Shmcandi/PCB-business-card-V2/fab_v2/BOM.csv

Comment/Value | Designator | Footprint | Quantity
100k | R7, R12 | R_0603_1608Metric | 2
100nF | C5, C9, C10 | C_0603_1608Metric | 3
10k | R4, R10 | R_0603_1608Metric | 2
10uF | C3, C4, C6, C8 | C_0805_2012Metric | 4
125k Wire Pads | J3 | PinHeader_1x02_P2.54mm_Vertical_SMD_Pin1Left | 1
125kHz Coil | L1 | L_1812_4532Metric | 1
1k | R6, R11 | R_0603_1608Metric | 2
1uF | C7 | C_0603_1608Metric | 1
3.3k | R3 | R_0603_1608Metric | 1
4.7k | R8, R9 | R_0603_1608Metric | 2
4.7uF | C1, C2 | C_0805_2012Metric | 2
470pF | C12 | C_0603_1608Metric | 1
5.1k | R1, R2 | R_0603_1608Metric | 2
AP2112K-3.3 | U3 | SOT-23-5 | 1
ATA5577C | U5 | SOIC-8_3.9x4.9mm_P1.27mm | 1
BATT JST-PH | J2 | JST_PH_S2B-PH-SM4-TB_1x02-1MP_P2.00mm_Horizontal | 1
BOOT | SW2 | SW_SPST_PTS810 | 1
BSS138 | Q2 | SOT-23 | 1
CHG | D1 | LED_0603_1608Metric | 1
DMG2305UX | Q1 | SOT-23 | 1
EN | SW1 | SW_SPST_PTS810 | 1
ESP32-C6-MINI-1-N4 | U1 | ESP32-C6-MINI-1 | 1
MCP73831T-2ACI/OT | U2 | SOT-23-5 | 1
NT3H2111W0FHK | U4 | TSSOP-8_3x3mm_P0.65mm | 1
NetTie-2 | NT1 | NetTie-2_SMD_Pad0.5mm | 1
USB-C (USB4105) | J1 | USB_C_Receptacle_GCT_USB4105-xx-A_16P_TopMnt_Horizontal | 1
USER | SW3 | SW_SPST_PTS810 | 1
WS2812B-2020 | LED59, LED55, LED26, LED87, LED67, LED21, LED79, LED37, LED25, LED44, LED96, LED93, LED6, LED15, LED63, LED66, LED94, LED13, LED18, LED60, LED12, LED46, LED78, LED86, LED28, LED75, LED89, LED19, LED29, LED43, LED56, LED20, LED34, LED52, LED64, LED69, LED82, LED83, LED33, LED80, LED38, LED42, LED9, LED48, LED40, LED51, LED8, LED50, LED74, LED32, LED22, LED88, LED2, LED17, LED1, LED4, LED11, LED58, LED3, LED7, LED65, LED77, LED85, LED39, LED71, LED76, LED53, LED61, LED45, LED14, LED23, LED16, LED47, LED24, LED5, LED10, LED49, LED84, LED90, LED95, LED41, LED62, LED68, LED91, LED27, LED73, LED35, LED72, LED54, LED31, LED92, LED57, LED70, LED81, LED36, LED30 | LED_WS2812B-2020 | 96
