Shmcandi/PCB-business-card-V2/card_v2.kicad_pcb

## KiCad design card_v2.kicad_pcb (2026-11-01)

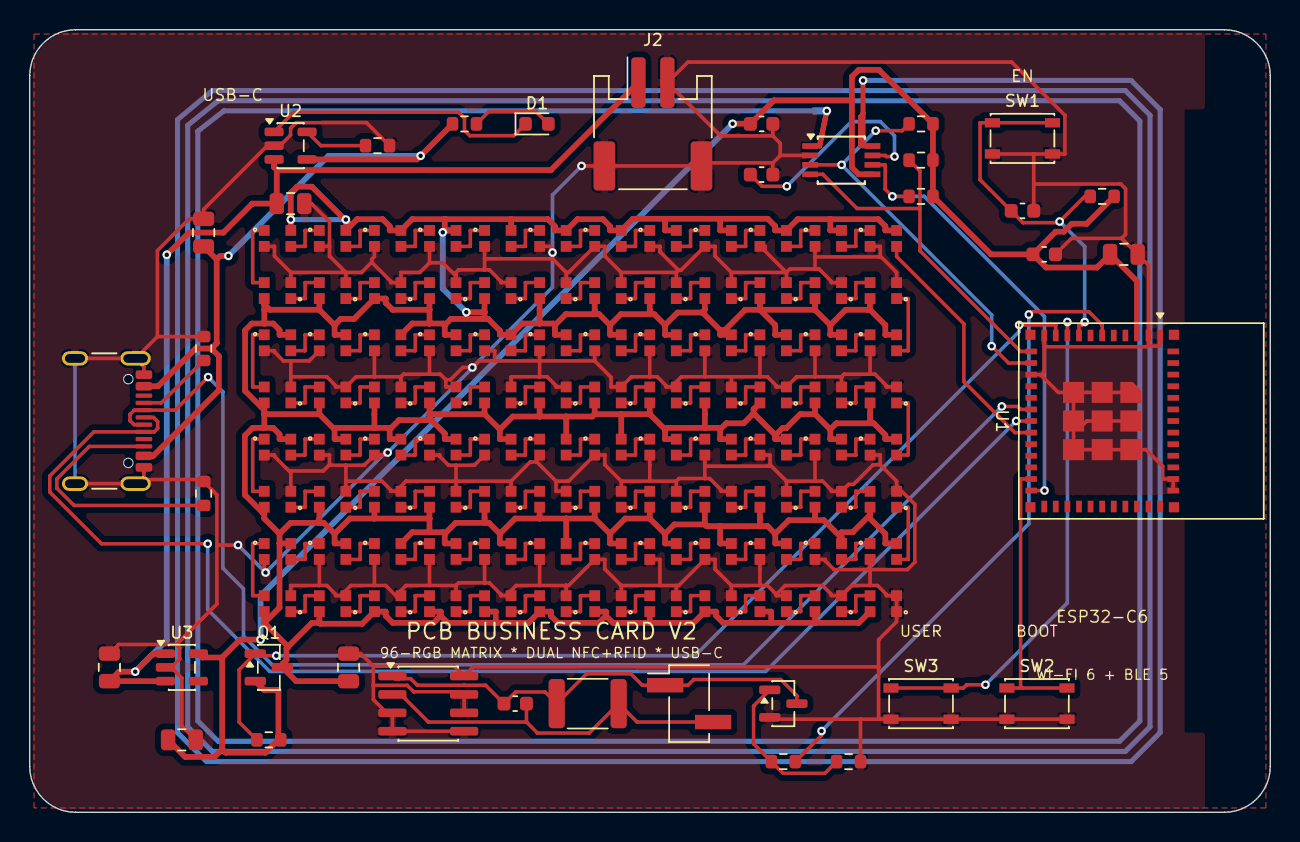
[picture p4: board card_v2.kicad_pcb from above]

Board: 2 copper layers, 85.6 x 54.0 mm, 134 parts (1 on the bottom side), 122 nets.

Parts:
C1, C2: 4.7uF; C_0805_2012Metric
C3, C4, C6, C8: 10uF; C_0805_2012Metric
C5, C9, C10: 100nF; C_0603_1608Metric
C7: 1uF; C_0603_1608Metric
C12: 470pF; C_0603_1608Metric
D1: CHG; LED_0603_1608Metric
J1: USB-C (USB4105); USB_C_Receptacle_GCT_USB4105-xx-A_16P_TopMnt_Horizontal
J2: BATT JST-PH; JST_PH_S2B-PH-SM4-TB_1x02-1MP_P2.00mm_Horizontal
J3: 125k Wire Pads; PinHeader_1x02_P2.54mm_Vertical_SMD_Pin1Left
L1: 125kHz Coil; L_1812_4532Metric
LED1, LED2, LED3, LED4, LED5, LED6, LED7, LED8, LED9, LED10, LED11, LED12, LED13, LED14, LED15, LED16, LED17, LED18, LED19, LED20, LED21, LED22, LED23, LED24, LED25, LED26, LED27, LED28, LED29, LED30, LED31, LED32, LED33, LED34, LED35, LED36, LED37, LED38, LED39, LED40, LED41, LED42, LED43, LED44, LED45, LED46, LED47, LED48, LED49, LED50, LED51, LED52, LED53, LED54, LED55, LED56, LED57, LED58, LED59, LED60, LED61, LED62, LED63, LED64, LED65, LED66, LED67, LED68, LED69, LED70, LED71, LED72, LED73, LED74, LED75, LED76, LED77, LED78, LED79, LED80, LED81, LED82, LED83, LED84, LED85, LED86, LED87, LED88, LED89, LED90, LED91, LED92, LED93, LED94, LED95, LED96: WS2812B-2020; LED_WS2812B-2020
NT1: NetTie-2; NetTie-2_SMD_Pad0.5mm
Q1: DMG2305UX; SOT-23
Q2: BSS138; SOT-23
R1, R2: 5.1k; R_0603_1608Metric
R3: 3.3k; R_0603_1608Metric
R4, R10: 10k; R_0603_1608Metric
R6, R11: 1k; R_0603_1608Metric
R7, R12: 100k; R_0603_1608Metric
R8, R9: 4.7k; R_0603_1608Metric
SW1: EN; SW_SPST_PTS810
SW2: BOOT; SW_SPST_PTS810
SW3: USER; SW_SPST_PTS810
U1: ESP32-C6-MINI-1-N4; ESP32-C6-MINI-1
U2: MCP73831T-2ACI/OT; SOT-23-5
U3: AP2112K-3.3; SOT-23-5
U4: NT3H2111W0FHK; TSSOP-8_3x3mm_P0.65mm
U5: ATA5577C; SOIC-8_3.9x4.9mm_P1.27mm

Connections:
3V3: C4.1, C5.1, C6.1, C9.1, Q1.2, R4.2, R7.2, R8.2, R9.2, R10.2, U1.3, U3.5, U4.5
BOOT: SW2.1, U1.23
BTN: SW3.1, U1.9
CC1: J1.A5, R1.1
CC2: J1.B5, R2.1
D_SIG_0: LED1.3, U1.19
D_SIG_1: LED1.1, LED2.3
D_SIG_2: LED2.1, LED3.3
D_SIG_3: LED3.1, LED4.3
D_SIG_4: LED4.1, LED5.3
D_SIG_5: LED5.1, LED6.3
D_SIG_6: LED6.1, LED7.3
D_SIG_7: LED7.1, LED8.3
D_SIG_8: LED8.1, LED9.3
D_SIG_9: LED9.1, LED10.3
D_SIG_10: LED10.1, LED11.3
D_SIG_11: LED11.1, LED12.3
D_SIG_12: LED12.1, LED13.3
D_SIG_13: LED13.1, LED14.3
D_SIG_14: LED14.1, LED15.3
D_SIG_15: LED15.1, LED16.3
D_SIG_16: LED16.1, LED17.3
D_SIG_17: LED17.1, LED18.3
D_SIG_18: LED18.1, LED19.3
D_SIG_19: LED19.1, LED20.3
D_SIG_20: LED20.1, LED21.3
D_SIG_21: LED21.1, LED22.3
D_SIG_22: LED22.1, LED23.3
D_SIG_23: LED23.1, LED24.3
D_SIG_24: LED24.1, LED25.3
D_SIG_25: LED25.1, LED26.3
D_SIG_26: LED26.1, LED27.3
D_SIG_27: LED27.1, LED28.3
D_SIG_28: LED28.1, LED29.3
D_SIG_29: LED29.1, LED30.3
D_SIG_30: LED30.1, LED31.3
D_SIG_31: LED31.1, LED32.3
D_SIG_32: LED32.1, LED33.3
D_SIG_33: LED33.1, LED34.3
D_SIG_34: LED34.1, LED35.3
D_SIG_35: LED35.1, LED36.3
D_SIG_36: LED36.1, LED37.3
D_SIG_37: LED37.1, LED38.3
D_SIG_38: LED38.1, LED39.3
D_SIG_39: LED39.1, LED40.3
D_SIG_40: LED40.1, LED41.3
D_SIG_41: LED41.1, LED42.3
D_SIG_42: LED42.1, LED43.3
D_SIG_43: LED43.1, LED44.3
D_SIG_44: LED44.1, LED45.3
D_SIG_45: LED45.1, LED46.3
D_SIG_46: LED46.1, LED47.3
D_SIG_47: LED47.1, LED48.3
D_SIG_48: LED48.1, LED49.3
D_SIG_49: LED49.1, LED50.3
D_SIG_50: LED50.1, LED51.3
D_SIG_51: LED51.1, LED52.3
D_SIG_52: LED52.1, LED53.3
D_SIG_53: LED53.1, LED54.3
D_SIG_54: LED54.1, LED55.3
D_SIG_55: LED55.1, LED56.3
D_SIG_56: LED56.1, LED57.3
D_SIG_57: LED57.1, LED58.3
D_SIG_58: LED58.1, LED59.3
D_SIG_59: LED59.1, LED60.3
D_SIG_60: LED60.1, LED61.3
D_SIG_61: LED61.1, LED62.3
D_SIG_62: LED62.1, LED63.3
D_SIG_63: LED63.1, LED64.3
D_SIG_64: LED64.1, LED65.3
D_SIG_65: LED65.1, LED66.3
D_SIG_66: LED66.1, LED67.3
D_SIG_67: LED67.1, LED68.3
D_SIG_68: LED68.1, LED69.3
D_SIG_69: LED69.1, LED70.3
D_SIG_70: LED70.1, LED71.3
D_SIG_71: LED71.1, LED72.3
D_SIG_72: LED72.1, LED73.3
D_SIG_73: LED73.1, LED74.3
D_SIG_74: LED74.1, LED75.3
D_SIG_75: LED75.1, LED76.3
D_SIG_76: LED76.1, LED77.3
D_SIG_77: LED77.1, LED78.3
D_SIG_78: LED78.1, LED79.3
D_SIG_79: LED79.1, LED80.3
D_SIG_80: LED80.1, LED81.3
D_SIG_81: LED81.1, LED82.3
D_SIG_82: LED82.1, LED83.3
D_SIG_83: LED83.1, LED84.3
D_SIG_84: LED84.1, LED85.3
D_SIG_85: LED85.1, LED86.3
D_SIG_86: LED86.1, LED87.3
D_SIG_87: LED87.1, LED88.3
D_SIG_88: LED88.1, LED89.3
D_SIG_89: LED89.1, LED90.3
D_SIG_90: LED90.1, LED91.3
D_SIG_91: LED91.1, LED92.3
D_SIG_92: LED92.1, LED93.3
D_SIG_93: LED93.1, LED94.3
D_SIG_94: LED94.1, LED95.3
D_SIG_95: LED95.1, LED96.3
EN: C7.1, R4.1, SW1.1, U1.8
GND: C1.2, C2.2, C3.2, C4.2, C5.2, C6.2, C7.2, C8.2, C9.2, C10.2, J1.A1, J1.A12, J1.B1, J1.B12, J1.SH, J2.2, J2.MP, LED1.2, LED2.2, LED3.2, LED4.2, LED5.2, LED6.2, LED7.2, LED8.2, LED9.2, LED10.2, LED11.2, LED12.2, LED13.2, LED14.2, LED15.2, LED16.2, LED17.2, LED18.2, LED19.2, LED20.2, LED21.2, LED22.2, LED23.2, LED24.2, LED25.2, LED26.2, LED27.2, LED28.2, LED29.2, LED30.2, LED31.2, LED32.2, LED33.2, LED34.2, LED35.2, LED36.2, LED37.2, LED38.2, LED39.2, LED40.2, LED41.2, LED42.2, LED43.2, LED44.2, LED45.2, LED46.2, LED47.2, LED48.2, LED49.2, LED50.2, LED51.2, LED52.2, LED53.2, LED54.2, LED55.2, LED56.2, LED57.2, LED58.2, LED59.2, LED60.2, LED61.2, LED62.2, LED63.2, LED64.2, LED65.2, LED66.2, LED67.2, LED68.2, LED69.2, LED70.2, LED71.2, LED72.2, LED73.2, LED74.2, LED75.2, LED76.2, LED77.2, LED78.2, LED79.2, LED80.2, LED81.2, LED82.2, LED83.2, LED84.2, LED85.2, LED86.2, LED87.2, LED88.2, LED89.2, LED90.2, LED91.2, LED92.2, LED93.2, LED94.2, LED95.2, LED96.1, LED96.2, Q2.2, R1.2, R2.2, R3.2, R12.2, SW1.2, SW2.2, SW3.2, U1.1, U1.2, U1.11, U1.14, U1.36, U1.37, U1.49, U2.2, U3.2, U4.2, U5.3, U5.4, U5.5, U5.6, U5.7, U5.8
I2C_SCL: R8.1, U1.13, U4.3
I2C_SDA: R9.1, U1.12, U4.4
LEDA: D1.2, R6.2
LED_EN: Q1.1, R7.1, U1.10
NFC_ANT_A: NT1.1, U4.1
NFC_ANT_B: NT1.2, U4.8
NFC_FD: R10.1, U1.24, U4.6
PROG: R3.1, U2.5
RFID_COIL1: C12.1, J3.1, L1.1, Q2.3, U5.1
RFID_COIL2: C12.2, J3.2, L1.2, U5.2
RFID_GATE: Q2.1, R11.1, R12.1
RFID_MOD: R11.2, U1.6
STAT: D1.1, U2.1
USB_DN: J1.A7, J1.B7, U1.17
USB_DP: J1.A6, J1.B6, U1.18
VBAT: C2.1, C3.1, J2.1, U2.3, U3.1, U3.3
VBUS: C1.1, J1.A4, J1.A9, J1.B4, J1.B9, R6.1, U2.4
VLED: C8.1, LED1.4, LED2.4, LED3.4, LED4.4, LED5.4, LED6.4, LED7.4, LED8.4, LED9.4, LED10.4, LED11.4, LED12.4, LED13.4, LED14.4, LED15.4, LED16.4, LED17.4, LED18.4, LED19.4, LED20.4, LED21.4, LED22.4, LED23.4, LED24.4, LED25.4, LED26.4, LED27.4, LED28.4, LED29.4, LED30.4, LED31.4, LED32.4, LED33.4, LED34.4, LED35.4, LED36.4, LED37.4, LED38.4, LED39.4, LED40.4, LED41.4, LED42.4, LED43.4, LED44.4, LED45.4, LED46.4, LED47.4, LED48.4, LED49.4, LED50.4, LED51.4, LED52.4, LED53.4, LED54.4, LED55.4, LED56.4, LED57.4, LED58.4, LED59.4, LED60.4, LED61.4, LED62.4, LED63.4, LED64.4, LED65.4, LED66.4, LED67.4, LED68.4, LED69.4, LED70.4, LED71.4, LED72.4, LED73.4, LED74.4, LED75.4, LED76.4, LED77.4, LED78.4, LED79.4, LED80.4, LED81.4, LED82.4, LED83.4, LED84.4, LED85.4, LED86.4, LED87.4, LED88.4, LED89.4, LED90.4, LED91.4, LED92.4, LED93.4, LED94.4, LED95.4, LED96.4, Q1.3
VOUT_NFC: C10.1, U4.7
