Shmcandi/PCB-business-card-V2/(commit log)

2026-11-01 Initial commit: PCB Business Card V2 (ESP32-C6, 96-RGB Micro-LED Matrix, USB-C, LiPo, C++ Firmware)
    [BOM.csv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]
2026-11-01 feat: add dual 13.56 MHz NFC (NTAG I2C Plus) and 125 kHz RFID (T5577) contactless engine
    [BOM.csv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]
2026-11-01 chore: remove firmware and code files, keep purely PCB design & manufacturing files
